rylincoln/OpenEVSE_PLUS/docs/research/v6.5.1-sourcing-research.md

# OpenEVSE PLUS v6.5.1 – station sourcing research

Scope: v6.5.1 only. That means the 2-layer EAGLE design (`OpenEVSE_PLUS_v6.5.1/`) and the 6-layer KiCad design (`OpenEVSE_PLUS_v6.5.1_6Layer/`). The KiCad schematic carries the same values as EAGLE for every part flagged below. Board BOM: `docs/research/v6.5.1-board-bom.csv`, generated from the EAGLE `.sch`. Use the BOM `value` column, not `eagle_device`.

The v6.5 drawing (`OpenEVSE_PLUS_v6.5.1/OpenEVSE_v6.5.pdf`, DWG 20250310) covers the board only. Station-level items it does not show are taken from older drawings, and each such row is tagged:
- **[v5.5]** = `OpenEVSE_PLUS_v5.5/Advanced_2024.pdf`, which the official v6.5.1 build guide links in its step 1;
- **[v5]** = `OpenEVSE_PLUS_v5/*.pdf`.

Source keys in brackets resolve in section 4. Research date: 2026-10-25.

---

## 1. Station-level parts list

### 1a. Board connectors and their mating parts

Pinouts come from the EAGLE netlist [SCH] and are cross-checked against [DWG65].

| Board ref (footprint) | Pinout (netlist) | Mating part / official SKU | Qty | Source |
|---|---|---|---|---|
| AC (JST VH, 6-pos, 3.96 mm) | 1 ACLIN, 2 ACNIN, 3 ACNIN, 4 ACRELAY (coil), 5 ACTEST2, 6 ACTEST1. All six are mains. | JST **VHR-6N** housing (VHR-6M = lance-covered variant). Contacts **SVH-21T-P1.1**, AWG 22–18; SVH-41T-P1.1 takes AWG 20–16. Board header family B6P-VH (top) / B6PS-VH (side). Official ready-made harness: contactor SKU **C240CW** ("Relay with Wiring Harness"), or a custom harness via support@openevse.com. Rating: see 2.18. | 1 housing + 6 contacts | [DWG65], [JST-VH], [ST-C240] |
| AMP_CT (Molex-style 2-pos, 2.54 mm) | 1 CT return (N$7), 2 AMP_READ. On board: R26 22 Ω burden and D11 clamp. | Official CT SKU **AMP** ships with its 2-pin connector. For a DIY lead: Molex KK 254 housing 22012027 (friction ramp) or 22013027 (with polarizing ribs), plus 2× crimp terminal 08500113 (30–22 AWG). | 1 | [ST-AMP], [MX-22012027], [MX-22013027], [MX-TERM] |
| DC_RELAY (Molex-style 3-pos, 2.54 mm) | 1 low-side drive (Q2), 2 +12 V, 3 low-side drive (Q3). Flyback diodes D5/D2 on board. | Optional; only for a 12 V DC-coil relay. Not used in the v6.5.1 Advanced kit. KK 254 housing 22012037 / 22013037 + 3× 08500113. | 0–1 | [SCH], [DWG65], [MX-22013037], [MX-2695] |
| GFCI_CT (4-pos, 2.54 mm) | 1 GND, 2 CT signal (N$20), 3 GFI_TEST_O, 4 GND. [DWG65] labels: Self Test 1/2, GFCI CT 1/2. | Official CT SKU **GFI** ships with a 4-pin connector. The board header is black in the [DWG65] photo, and no header MPN is in the BOM. Candidate DIY housing: KK 254 22012047 + 4× 08500113, if the fitted header is KK 254 (unverified). | 1 | [ST-GFI], [MX-2695] |
| FTDI (JST PH, 6-pos, 2.0 mm) | 1 GND, 2 **+12 V**, 3 +5 V, 4 RX-I, 5 TX, 6 RESET. | Housing **PHR-6** + contacts **SPH-002T-P0.5S** (AWG 30–24). Board header B6B-PH-K-S. Official cables: the Color LCD/WiFi and WiFi kits include a "custom power/communications cable", and SKU USBTTL includes a "6 pin to 6 pin (4 wires)" cable. **Conflict:** [DWG65] labels pin 2 "N/C", but the schematic puts +12 V on it, and [ADV24] shows that pin feeding the LCD's "+5v–16v DC" input. | 1 | [SCH], [DWG65], [ADV24], [JST-PH], [ST-LCD], [ST-USB] |
| I2C (JST PH, 4-pos, 2.0 mm) | 1 GND, 2 +5 V, 3 SCL, 4 SDA. | **PHR-4** + 4× SPH-002T-P0.5S. Board header B4B-PH-K-S. The official temperature sensor (MCP9808) ships with a 4-pin cable. | 1 | [SCH], [JST-PH], [ST-TEMP] |
| JP2 (Molex 1×6 friction-lock, 2.54 mm) | 1 PILOT, 2 GND, 3 PP, 4 GND, 5 PP2, 6 +5 V. Matches [DWG65]. | Optional (alternative CP/PP connection). KK 254 housing 22012067 / 22013067 + 6× 08500113. The guide does not use JP2. | 0–1 | [SCH], [DWG65], [MX-22012067], [MX-22013067] |
| PILOT (5 mm 2-pos screw terminal; BOM STOREFRONT_ID PRT-08432) | 1 PILOT (CP), 2 PP. | Takes the EV cable's 22 AWG pilot conductor with ferrule **Phoenix 3200014** (in the store ferrule kit). | 1 ferrule | [BOM], [ST-J1772], [ST-FER] |
| ISP1 (2×3 AVR-ISP) | Standard AVR ISP. | Official programmer SKU **ISP** (includes a "10 pin to 6 pin low profile cable"). | tool | [ST-ISP] |
| G1 (PE) / G2 (GND) single PTH pads; U$3 (PE) / U$9 (GND) mounting holes | The PE net includes G1, U$3, M3/M4 and the IC8 LED cathodes. The GND net includes G2 and U$9. | Earth bonding is "via ground plane metallic plate/hardware" **[v5.5]**. Neither drawing specifies a wire termination for G1/G2 (open question). | – | [SCH], [ADV24] |

### 1b. Station blocks ([DWG65], [ADV24] **[v5.5]**, [GUIDE])

| Block | Qty | Spec | Example MPN / official SKU | Source |
|---|---|---|---|---|
| Controller | 1 | OpenEVSE PLUS v6.5: "Continuous Ground Monitoring", on-board surge suppression, 10 W PSU | Store SKU PLUSv5 ($149) | [ST-CTRL] |
| Contactor (2-pole) **[v5.5]** | 1 | UL E222997; 50 A resistive / 40 A inductive; 600 VAC max; **208–240 VAC coil**, 50/60 Hz; 3"×2"×2.5". "Input and EV wires MUST be terminated with sleeve ferrules." Coil VA/current **not published**. | Packard **C240C** (SKU C240C, or C240CW with harness) | [ST-C240] |
| EV cable | 1 | J1772 Type 1, 48 A, 9 conductors (4×12 AWG, 1×10 AWG, 4×22 AWG), 300 V 105 °C, cULus, 25 ft, ferrule-terminated | Phoenix Contact **EV-T1G2C-1AC48A-25FT12ASBK11U** (SKU PHX-J1772-48A-25F). Alternative: NACS SKU NACS48A-25. | [ST-J1772], [ST-NACS] |
| GFCI CT | 1 | CCID20 (15–20 mA trip); 4-pin connector; 5-turn self-test winding (internal on current coils); nickel core; 105 °C leads; UL E235509 | Store SKU **GFI**. Drawing PN **CR8420-1K-GT7QC** (see 2.19). | [ST-GFI], [DWG65], [GUIDE] |
| Current CT | 1 | 80 A max; 2-pin connector; −40 to 105 °C; UL E235509 | Store SKU **AMP**. Drawing PN **CR8450-1K-T7QC** (see 2.19). | [ST-AMP], [DWG65] |
| LCD + WiFi **[v5.5]** | 1 | ESP32, 16 MB flash, 3.5" colour LCD, 4 RGB LEDs, I2C expansion; powered from FTDI header pin 2 (+12 V; input rated "+5v–16v DC") | OpenEVSE **Color LCD/WiFi** ($79). Alternative: WiFi kit SKU WIFI (no display). Design files: [ESP32HW]. | [ST-LCD], [ST-WIFI], [ADV24] |
| Temperature sensor **[v5.5]** | 1 | MCP9808 on 5 V I2C; 4-pin cable | Store "Temperature Sensor" ($12.99) | [ST-TEMP], [MC-9808], [ADV24] |
| LED expansion **[v5.5]** | 0–4 | 3-pixel RGB strips on the display's LED EXP header, 3-pin 9" cable | SKU RGBPIXEL3X (optional) | [ST-PIX], [ADV24] |
| Qwiic 3.3 V I2C **[v5.5]** | 0 | Header on the LCD/WiFi module (RFID/NFC etc.) | No part specified (optional) | [ADV24], [ST-LCD] |
| Enclosure + base plate | 1 | Polycarbonate 8"×5"×3", UL 746C 5VA, UL 508A Type 1/2/4/4X/12/13, UL E352997; bundle includes base plate, hardware pack and 2 small glands | SKU **P-ENC-S** (Enclosure Bundle, $69.99) | [ST-ENC] |
| Cable glands / strain relief | 2 | UL E51579; nylon 6/6; TPE seal; cable OD 0.450–0.709"; one for input (left), one for EV cable (right) | SKU **CGSMALL** (Heyco Series 35 datasheet linked by the store) | [ST-GLAND], [HEYCO], [GUIDE] |
| Input cable or hardwire | 1 | 105 °C, ferrule-terminated. 48 A continuous on NEMA 14-60, 40 A on 14-50, 24 A on 14-30; blunt option for hardwire. Kit rated 208–264 VAC, circuits ≤60 A, 50 A max continuous output. | SKU **14XX** | [ST-IN], [ST-KIT] |
| Ferrules | 1 kit | 5× 6 AWG power, 5× twin 12 AWG power, 2× 10 AWG ground, 2× pilot | Phoenix **3200140**, **3201000**, **3200108**, **3200014** (store "Wire Ferrule Kit"; the store text shows the Digi-Key numbers 349917/349965/349914/349905) | [ST-FER] |
| Ground bar **[v5.5]** | 1 | Terminates input and EV-cable grounds; mounted to the plate with 1 washer + one 1/4" self-threading screw | MPN not published (open question) | [ADV24], [GUIDE] |
| Controller standoffs + screws | 4 + 8 | 4.5 mm hex × 10 mm standoffs. 4× M2.5×6 into the plate (blue Loctite) and 4× M2.5×6 for the controller. | Enclosure hardware pack | [GUIDE], [ST-ENC] |
| Contactor screws | 4 | 1/4" self-threading | Hardware pack | [GUIDE] |
| Plate screws | 6 | Coarse-thread 6 mm | Hardware pack | [GUIDE] |
| Lid screws | 6 | 6-32 × 1-1/4" | Hardware pack | [GUIDE] |
| Wire management | – | Zip ties near the CTs; route LV wires low and HV wires high | No part | [GUIDE] |
| Holster | 0–1 | UV-treated polycarbonate J1772 holster/cord wrap | SKU JHOLSTER | [ST-HOL] |
| Button **[v5]** | 0–1 | Button header on the LCD (v5 drawings); the RGB LCD v3 has a "3 pin header for button". Not shown on v6.5 or [ADV24]. | No MPN published | [STD5], [ST-RGB] |
| Cable lock **[v5]** | 0 | Only for socketed (IEC) stations: "Requires external 12V Supply and motor driver such as Polulu 1451". Not applicable to a tethered J1772 cable. | Pololu 1451 (per drawing) | [STD3P] |
| Programming / serial | tool | ISP programmer (firmware). USB-TTL "Serial is not supported for firmware upload". | SKUs ISP, USBTTL | [ST-ISP], [ST-USB] |

---

## 2. Datasheet checks

Verdicts: confirmed / refuted / unclear. "Calc" marks arithmetic of mine that uses the cited figures.

| # | Claim checked | Verdict | Exact figure(s) | Source |
|---|---|---|---|---|
| 2.1 | LMV358 (IC1 value) can run on ±12 V | **Refuted** | Abs max supply (V+ − V−) **5.5 V**; recommended 2.7–5.5 V. ±12 V = 24 V. LMV358A abs max 6 V. The part fitted as IC1 cannot be an LMV358; both the EAGLE and KiCad schematics list "LMV358". | [TI-LMV358], [TI-LMV358A], [BOM], [KSCH] |
| 2.2 | LM358 as open-loop pilot comparator (+IN 0/5 V PWM, −IN 2.5 V, OUT→820 Ω→CP) | **Refuted** for the J1772 edge requirement. Supply and input range are OK. | **Supply:** abs max ±16 V / 32 V (LM358B ±20 V / 40 V); recommended 3–30 V. **Input:** VCM V− to V+ − 2 V, so the 0–5 V inputs are within range. **Slew:** 0.3 V/µs (LM358B 0.5 V/µs). Calc: a 10–90 % swing of 24 V is 19.2 V, which takes 64 µs (LM358B 38 µs) against a < 2 µs requirement (2.5). **Positive swing:** 2 V typ / 3 V max below V+ (VS 30 V, RL ≥ 10 kΩ); 4 V max at RL 2 kΩ. **Output current:** source 20 mA min / 30 mA typ; sink 10 mA min / 20 mA typ. | [TI-LM358], [TI-FE6] |
| 2.3 | LF353 as the pilot driver | **Unclear** (edges pass at typical slew, fail at minimum; swing short of ±12 V) | **Supply:** ±18 V max. **Swing:** VOM ±12 V min / ±13.5 V typ at ±15 V supply, RL 10 kΩ, i.e. 1.5–3 V headroom. Calc: about ±9 to ±10.5 V at ±12 V rails. **Slew:** 8 min / 13 typ V/µs. Calc: 19.2 V takes 1.5 µs typ, 2.4 µs at minimum. **Input:** VCM from V− + 4 V to V+ − 4 V (±8 V at ±12 V rails), so the 0–5 V inputs are in range. | [TI-LF353], [TI-FE6] |
| 2.4 | TL082 as the pilot driver | **Unclear** (same pattern as LF353) | **Supply:** VS max 36 V (TL08xM, NS/PS packages) or 42 V (others); recommended 4.5–40 V. **Swing:** VOM ±13.5 typ / ±12 min (RL 10 kΩ), ±10 min (RL ≥ 2 kΩ), at ±15 V. **Slew:** 8 min / 20 typ V/µs (TL08xC/I). Calc: 1.0 µs typ, 2.4 µs at minimum. **Input:** range starts at V− + 4 V. | [TI-TL082] |
| 2.5 | J1772 / IEC 61851-1 pilot generator requirements (for SPICE) | **Confirmed** from a first-party summary. **Unclear:** tolerances. | **Signal:** ±12 V, 1 kHz, 1 kΩ source. Driver needs "a minimum of ±12mA sinking and sourcing current with a rise time and fall time < 2μs, per SAE J1772", measured 10–90 % at the generator before the 1 kΩ resistor. **States:** A 12 V DC (open); B1 9 V DC (EV load 2.74 kΩ); B2 9 V / −12 V at 1 kHz; C 6 V (2.74 kΩ ∥ 1.3 kΩ = 882 Ω, through the EV diode); D 3 V (246 Ω); E 0 V; F −12 V. **Boundary bands:** B 8/9/10 V, C 5/6/7 V, D 2/3/4 V. **Duty:** 5 % = digital communication. **Not found in any free first-party document:** the ±12 V amplitude tolerance (±0.6 V?) and the 1 kΩ ±3 % source tolerance. SAE J1772 and IEC 61851-1 are paywalled. Board fact: R1 = **820 Ω**, not 1 kΩ, so 180 Ω would have to come from the driver output impedance; whether that is intentional is unverified. | [TI-FE6], [TI-BV2], [SAE-J1772], [IEC-61851], [SCH] |
| 2.6 | TC1044S on the +12 V rail; output resistance | **Unclear / marginal** | **Abs max supply:** +13 V. **Operating range** VH2 (LV open): 3–12 V over temperature. IRM-10-12 can sit at 12.3 V (12 V ±2.5 %), which exceeds the 12 V operating max but stays below the 13 V abs max. The IRM's OVP (13.8–16.2 V) trips above the TC1044S abs max. **ROUT:** 60 typ / 100 max Ω at V+ = 5 V, IOUT 20 mA; 70/120 Ω at −40…85 °C; not specified at 12 V. **FOSC:** 10 kHz, 45 kHz with BOOST = V+ (as wired). **Supply current with boost:** ≤350 µA (−40…85 °C). | [MC-TC1044], [MW], [SCH] |
| 2.7 | AP63203 vs AP63205; effect of FB tied to the output | **AP63203 refuted** for this net | AP63203 is a fixed 3.3 V part (VFB 3.27/3.30/3.33 V). AP63205 is a fixed 5 V part (4.95/5.00/5.05 V). The datasheet's typical circuit ties FB of the AP63205 directly to VOUT. On the board FB sits on the output net "+5V" (after L2) with no divider, so an **AP63203 regulates "+5V" to 3.3 V**. **Consequences:** the ATmega328P at 16 MHz needs 4.5–5.5 V ("0–20 MHz @ 4.5–5.5 V"); the AQH2223 LED current falls to about (3.3 − 1.18)/330 ≈ 6.4 mA (calc), below IFT max 10 mA (2.13). **Recommended parts:** AP63205: L 4.7 µH, C1 10 µF, C2 2×22 µF, C3 (BST) 100 nF. AP63203: L 3.9 µH. The general range is 2.2–10 µH, so the fitted 3.3 µH is inside it. **Marking:** AP63203WU-7 = T4, AP63205WU-7 = T5, which lets you check a populated board. | [DI-AP], [MC-328], [SCH] |
| 2.8 | Mean Well IRM-10 variant, temperature range, input vs 277 VAC | **Confirmed**, with derating caveats. **BOM value refuted.** | **Models:** -3.3/-5/-12/-15/-24; IRM-10-12 = 12 V, 0.85 A. **Input:** 85–305 VAC / 120–430 VDC, 0.125 A typ at 277 VAC; leakage < 0.25 mA at 277 VAC. **Working temperature:** −30 to +85 °C "(Refer to Derating Curve)"; the curve reads 100 % load to 50 °C, 50 % at 70 °C, ~10 % at 85 °C. **Ratings:** OVC III per IEC 61558-1/-2-16, OVC II per IEC/UL 62368-1; I/P–O/P 4.2 kVAC; Class II. **BOM vs board:** the BOM says "IRM-10-5", but PS1 V+ is on the +12V net and the [DWG65] photo shows an IRM-10-12 labelled "277VAC for North America only". | [MW], [DWG65], [SCH] |
| 2.9 | 1210 thick-film resistors (R32–R39, 2×180 kΩ per branch) at 277 VAC | **Confirmed** on rms voltage and power. Per-resistor peak is close to 200 V. | **Yageo RC1210:** 1/2 W at 70 °C; max working 200 V (DC or AC rms, or √(P·R) if lower; √(0.5×180k) = 300 V, so 200 V governs); max overload 500 V; dielectric withstand 500 V. **Calc** (diode blocks the reverse half-cycle): at 277 VAC (391.7 Vpk), Ipk ≈ 1.08 mA, 195 Vpk / 97 Vrms per resistor, P ≈ 53 mW. At 305 VAC (+10 %): 1.19 mA, 215 Vpk / 107 Vrms, 64 mW (about 13 % of rating). | [YAG-RC], [SCH] |
| 2.10 | HCPL-2731: LED current, CTR, CTR ageing | **Confirmed** at 230/277 V L–PE. **Unclear** at 120 V L–PE. | **CTR:** 400 % min / 1800 typ / 5000 max at IF 0.5 mA, VCC 4.5 V. **Recommended IF(ON):** 0.5–12 mA. **LED limits:** IF(avg) 20 mA; VR 5 V; VF 1.4 typ / 1.7 max V at 1.6 mA. Guaranteed 0–70 °C; operating −40 to 85 °C. **Ageing:** "high CTR reduce the magnitude and effects of CTR degradation"; Broadcom's lifetime paper says "CTR < 10% loss after 30 field years of typical operations". **Calc peak IF:** 1.08 mA at 277 V; **0.465 mA at 120 V L–PE** (240 V split-phase or 208 V wye), which is below the 0.5 mA guaranteed-CTR point. **Board facts:** outputs have no external pull-ups (they rely on the MCU); onsemi HCPL2731S is obsolete/NRND. | [BRCM-2731], [BRCM-LED], [ON-2731], [SCH] |
| 2.11 | Tantalum derating: C17 10 µF 6.3 V on VCC (≈5 V) | **Refuted** (if MnO2) | KEMET T491 (MnO2): recommended max application voltage **50 % of VR** at −55 to 85 °C, 33 % at 85–125 °C. Calc: 5 V / 6.3 V = 79 % of VR, against a 3.15 V allowance; a 10 V part at 5 V = 50 %. The fitted part's chemistry and MPN are unknown (BOM gives only SparkFun PROD_ID CAP-13210). C14/C22 (10 µF EIA3216, polarized) have no voltage rating in the BOM. C22 sits on +12 V: calc 12.3 V / 25 V = 49 %. | [KEM-T491], [BOM], [SCH] |
| 2.12 | MLCC DC-bias loss, 10 µF 0805 at 12 V | **Confirmed**: large loss | TDK C2012X5R1E106K125AB (10 µF 25 V X5R 0805), 25 °C reference curve: 4.80 µF at 5 V, 2.19 µF at 10 V, **1.67 µF at 12.5 V (−83 %)**, 0.74 µF at 25 V. Affected 10 µF 0805 parts: C6, C28 (+12 V), C5 (−12 V), C13 (charge-pump flying cap). The BOM gives no voltage rating for them. For comparison, 22 µF 16 V 0805 (C2012X5R1C226K125AC) gives 6.97 µF at 5 V (−68 %). This matters for C29/C33. | [TDK-106], [TDK-226], [BOM], [SCH] |
| 2.13 | AQH2223 driving the contactor coil | **Unclear** | **Ratings:** non-zero-cross; VDRM 600 V; IT(rms) 0.9 A (graph: flat to ~40 °C, ~0.3 A at 85 °C); ITSM 9 A (60 Hz, 1 cycle); IH max 25 mA; IFT max 10 mA (recommended IF 20 mA); VF 1.18 typ V; IDRM 100 µA; dv/dt 200 V/µs min; Viso 5000 VAC; Topr −30 to +85 °C. **Loads:** "handles both 100 and 200 V AC loads"; recommends a snubber or varistor on the load side (M1 sits across the coil, ACNIN–ACRELAY). **Calc LED current:** ≤ (5.0 − 1.18)/330 = 11.6 mA (less MCU pin drop), which is above IFT max but below the recommended 20 mA. **Open:** the C240C coil current is unpublished, so IT and IH margins cannot be checked. Manufacturer URL not found; a mirror of Panasonic document ASCT1B272E was used. | [PAN-AQH], [SCH], [ST-C240] |
| 2.14 | P6SMB16CA standoff vs ±12 V pilot | **Confirmed** | VWM 13.6 V; VBR 15.2–16.8 V at 1 mA; IR ≤ 1 µA at VWM; VC 22.5 V at IPPM 26.7 A; bidirectional (CA). Calc: ±12.3 V worst case < 13.6 V. | [VIS-P6] |
| 2.15 | MOVs line-to-PE (M3 L–PE, M4 N–PE; M2 L–N, M1 across coil): leakage, ground-fault interaction, thermal protection | **Unclear** (BOM gives no rating; standards paywalled) | **BOM:** value "MOV", no voltage. Footprint pad offset Δx 9.89 mm / Δy 2.54 mm. **UltraMOV V20E320P:** MCOV 320 VAC / 420 VDC, 273 J, 10 kA, VN 459–561 V, VC 840 V at 100 A; 20 mm lead spacing 9–11 mm fits the footprint. V20E300P (300 VAC) is below 305 V (277 + 10 %). **TMOV20RP320E (thermally protected):** same electrical class; its "thermally activated element designed to open" under UL 1449 abnormal-overvoltage limited-current conditions; UL1449 E320116; GFCI listed as an application. Its 7.5 mm lead spacing does not fit. **Leakage:** neither datasheet tabulates standby current at MCOV (UltraMOV: "characterized for maximum standby current"). **Ground-fault interaction:** the CCID CT encloses the EV-cable conductors (guide step 5), so the board's L/N–PE currents are not seen by the station's own CCID; an upstream RCD/GFCI breaker does see them. Continuous L–PE contributors: IRM-10 < 0.25 mA at 277 V (output bonded to PE); HCPL ground-monitor branch ≈ 0.54 mA rms per energised channel at 277 V (calc, 2.9). MOV leakage is not quantified. UL 2231 / UL 2594 / IEC 61851-1 requirements are not consulted (paywalled). | [SCH], [LF-UMOV], [LF-UMOVP], [LF-TMOV], [GUIDE], [MW], [UL-2594], [IEC-61851] |
| 2.16 | 1N4004 vs an SMA equivalent (D7–D10) | **Refuted** as listed | **1N4004:** DO-41 only, "NOT RECOMMENDED FOR NEW DESIGNS"; 400 V; doesn't fit the SMA pads. The footprint's library device is **MBRA340T3** (a 40 V Schottky), so ordering by device name is dangerous. **Diodes S1x SMA:** VRRM 400 V (S1G) / 600 V (S1J) / 1000 V (S1M); 1 A; IR 5 µA; suggested pad spacing C = 4.00 mm, matching the 4.0 mm pad centres. **Calc reverse voltage** on D7/D9 with 277 V L–N (N≈PE): ≈392 Vpk, **431 V at +10 %**, so S1G/1N4004 (400 V) is insufficient. At 240 V split-phase the reverse voltage is ≈171 Vpk (D8 clamps the shared node). | [DI-1N], [DI-S1], [SCH], [BOM] |
| 2.17 | Reinforced/basic creepage and clearance, mains (≤277 VAC) to SELV; verdict on the 4.3–4.7 mm gap ACLIN (IC7 pin 8) ↔ +5V (IC8 pin 8), top layer, no slot, default net class | **Basic at PD2: adequate. Reinforced at OVC III: not adequate. PD3: unclear.** | **Status of the standards:** IEC 60664-1 is paywalled; the VDE preview of ed. 3.1 (2025) shows only the ToC. Figures below are TI's reproduced subsets. **Impulse (Table F.1, ≤300 V L–N):** OVC II 2.5 kV, OVC III 4.0 kV; reinforced = one step higher (4.0 / 6.0 kV). **Clearance (Table F.2, PD2):** 2.5 kV → 1.5 mm, 4.0 kV → 3.0 mm, 6.0 kV → 5.5 mm. IEC 62368-1 Table 10: 1.8 / 3.8 / 7.9 mm. PD3: 0.8 mm floor; higher PD3 values not in the free excerpt. **Creepage (Table F.4, 400 V row, a bound above 300/320 V):** PD1 1.0 mm; PD2 MG I 2.0, MG II 2.8, **MG III 4.0 mm**; reinforced doubles this (MG III 8.0 mm). The printed-wiring PD2 column at 400 V gives 2.0 mm basic / 4.0 mm reinforced. FR4 is typically MG IIIa. The 320 V row and PD3 creepage are not freely available. **Basic vs reinforced:** TI's table lists primary ↔ *earthed* SELV as basic and primary ↔ *unearthed* SELV as reinforced. Board GND is bonded to PE (U$9/G2 + metal plate, [ADV24]). The end-product standard (IEC 61851-1 / UL 2231 / UL 2594) decides and was not consulted. **Verdict for 4.3–4.7 mm:** basic passes clearance up to OVC III (3.0 mm; 3.8 mm under 62368-1) and creepage (≤ 4.0 mm). Reinforced fails OVC III clearance (5.5 mm) and MG III creepage (8.0 mm); it passes only with OVC II and the printed-wiring column (4.0 mm, marginal). The gap was measured on the EAGLE 2-layer board; the 6-layer layout was not measured. **Components:** HCPL-2731 DIP-8 external clearance 7.1 mm / creepage 7.4 mm (SO-8 4.9 / 4.8 mm); CTI 200, material group IIIa; VISO 3750 Vrms; VIORM 630 Vpk and installation class I–IV at ≤300 Vrms (IEC 60747-5-5, **option 060 only**). AQH2223: Viso 5000 VAC, Riso ≥ 50 GΩ; **no creepage/clearance figure published**. | [TI-419], [TI-AR5], [VDE-60664], [IEC-60664], [BRCM-2731], [PAN-AQH], [SCH], [ADV24] |
| 2.18 | JST VH carries 277 VAC (mains, coil and AC-test all on one VH 6-pin) | **Refuted** | **JST VH:** voltage rating **250 V AC/DC**; 10 A (AWG 16, standard header) / 7 A (AWG 18, shrouded header); −40 to +105 °C. JST lists UL E60389 / CSA LR20812 / TÜV R75122 registrations with no voltage, and notes "specifications registered to overseas standards may differ". 277 VAC exceeds 250 V. **Official ranges:** the kit range of 208–264 VAC also tops 250 V. The guide says "100 to 250v". The C240C coil is 208–240 VAC. **No VH variant ≥300 V found.** **Same-pitch ≥300 V family (not intermateable with VH):** Molex KK 396: header 26604060 (3.96 mm, **600 V AC (RMS)/DC**, 7.0 A); housing 09503061 (6-ckt); terminal 08500106 (18–24 AWG). Footprint/hole compatibility with the JST-VH-6 pads is unverified. | [JST-VH], [JST-REG], [ST-KIT], [GUIDE], [ST-C240], [MX-26604060], [MX-09503061], [MX-08500106] |
| 2.19 | CT part numbers CR8420-1K-GT7QC (GFCI), CR8450-1K-T7QC (current) | **Unclear** | **Not on CR Magnetics' public CR8400 page.** Closest catalogue parts: **CR8420-1000-G** (ground fault, nickel): Ir 20 A, Vmax 1.4 V, Te 1011, DCR 44 Ω. **CR8450-1000:** Ir 100 A, Vmax 16.5 V, Te 1021, DCR 21 Ω, "Custom Lead Lengths Available". Series-wide: insulation 3500 VAC / 1 min; −40 to +85 °C (general purpose and nickel). The "-1K-…T7QC" suffixes look like custom variants; confirm with CR Magnetics or OpenEVSE. OpenEVSE's store lists UL E235509, 105 °C leads and −40…105 °C for both CTs, which differs from the catalogue's 85 °C. | [CRM], [DWG65], [ST-GFI], [ST-AMP] |
| 2.20 | Manufacturer SPICE models (TI) | **Confirmed** (zips download) | **LF353:** SLOJ039 (LF353.301, 1989 Boyle-type macromodel). **TL072:** SLOJ067. **TL082:** SLOJ070. **LM358 / LMx58-LM2904:** PSpice Rev C, SNOM268 (lmx58_lm2904.lib). **LM358B:** PSpice SLOM472; TINA-TI SLOM473. | [TI-SPICE] |
| 2.21 | ATmega328P supply for 16 MHz (relevant to 2.7) | **Confirmed** | Speed grades: 0–4 MHz @ 1.8–5.5 V, 0–10 MHz @ 2.7–5.5 V, 0–20 MHz @ 4.5–5.5 V. Q1 = 16 MHz. | [MC-328], [BOM] |

Plain statements where primary sources contradict the brief or the design files:
- **IC1 "LMV358" cannot run on ±12 V** (2.1).
- **U1 "AP63203" would make the "+5V" rail 3.3 V** (2.7).
- **"IRM-10-5" is a BOM error;** the board uses IRM-10-12 (2.8).
- **277 VAC exceeds the JST VH rating** (250 V), and also exceeds the C240C coil rating and the official kit range (2.18).
- **FTDI pin 2:** [DWG65] says N/C, while the schematic says +12 V.
- **±0.6 V / 1 kΩ ±3 % pilot tolerances:** not confirmed by any free first-party source (2.5).
- **Official v6.5.1 build guide:** it links the v5.5 drawings in step 1 and refers to the "v5 Diagram" in step 9.

---

## 3. Corrected sourcing lines

| BOM line (value / device) | Problem | Orderable MPN or open question | Source |
|---|---|---|---|
| **C29, C33** "22" on 1.0UF-0805-25V (PROD_ID CAP-11625 = 1.0 µF) | The value field reads 22, but the device and PROD_ID say 1.0 µF. The netlist puts them on +5V/GND as U1 output caps. | **22 µF**, per the AP6320x tables (C2 = 2×22 µF). Example: TDK **C2012X5R1C226K125AC** (22 µF ±10 %, 16 V, X5R, 0805). Note it is ≈7.0 µF each at 5 V. **Open:** whether 0805 is intended. | [DI-AP], [TDK-226], [SCH] |
| **C32** "100nf" on the same 1.0 µF device | The netlist places it BST–SW, i.e. the bootstrap cap. | **100 nF**, per the datasheet C3. Example: TDK **C2012X7R1H104K085AA** (0.1 µF, 50 V, X7R, 0805). | [DI-AP], [TDK-104], [SCH] |
| **IC2** ATMEGA328P-AU, attribute MPN=ATMEGA8-16AU (and Farnell/Newark codes) | The MPN attribute is left over from the atmel/MEGA8-AI library device. | Microchip **ATmega328P-AU** (tray) / **ATmega328P-AUR** (T&R), 32A TQFP. Firmware target m328p. | [MC-328], [FW], [BOM] |
| **R32–R39** "180k" on 0.1OHM-1/2W-1%(1210), PROD_ID RES-12374 | The device name and PROD_ID describe a 0.1 Ω part. | Yageo **RC1210FR-07180KL** (180 kΩ, 1 %, 1/2 W, 200 V). The MPN is built from the RC_L ordering-code scheme; availability was not checked. | [YAG-RC], [BOM] |
| **Q2, Q3** "2222A" on BCX70* SMD (SOT-23) | Generic value. | Diodes **MMBT2222A-7-F** (SOT-23, marking K1P; VCEO 40 V, VCBO 75 V, IC 600 mA). The library maps B=1, E=2, C=3; check against the datasheet's pinout drawing. | [DI-2222], [SCH] |
| **U1** AP63203 (SparkFun VREG-15244) | Gives 3.3 V on "+5V" (2.7). | **AP63205WU-7** (marking T5). **Open:** confirm the fitted part from a board's marking (T4 = AP63203). | [DI-AP] |
| **L2** 3.3 µH (NR5040 footprint) | Inside the datasheet range of 2.2–10 µH; Table 3 recommends 4.7 µH for AP63205. | Optional 4.7 µH: Taiyo Yuden **LCXND5050YAL4R7NMG** (successor to NRS5040T4R7NMGKV; 4.7 µH ±30 %, 3.1 A, 4.9×4.9×4.1 mm). Footprint fit not checked. | [DI-AP], [TY-L] |
| **PS1** IRM-10-5 | Contradicted by the +12V net and the board photo. | Mean Well **IRM-10-12**. | [MW], [DWG65] |
| **IC1** LMV358 | Cannot run on ±12 V. | **Open:** identify the fitted IC1. Checked candidates: LM358 is too slow; LF353/TL082 are borderline (2.2–2.4). | [TI-LMV358] |
| **IC8** HCPL-2731S (onsemi naming) | onsemi HCPL2731S is obsolete/NRND. | Broadcom **HCPL-2731-500E** (gull-wing, T&R) or **-300E** (gull-wing, tube); **-560E / -360E** add IEC 60747-5-5. Check the gull-wing lead span against the 10.16 mm pad rows. onsemi's replacement is HCPL273xM. | [BRCM-2731], [ON-2731] |
| **IC7** AQH2223 (SIL8 SMD footprint) | The base part number is the DIP version. | Panasonic **AQH2223A** (SMD terminal, tube) / **AQH2223AX** or **AQH2223AZ** (tape & reel, by pin orientation). **Open:** current Panasonic production status (manufacturer page not found). | [PAN-AQH] |
| **IC4** TC1044S | No temperature grade given. | Microchip **TC1044SEOA** (SOIC-8, −40 to +85 °C) or TC1044SCOA (0–70 °C). | [MC-TC1044] |
| **D7–D10** "1N4004" on MBRA340T3 (SMA) | DO-41 part on an SMA footprint whose device is a 40 V Schottky; 400 V is too low for 277 V (2.16). | Diodes **S1M-13-F** (1000 V) or **S1J-13-F** (600 V). | [DI-S1], [DI-1N] |
| **M1–M4** "MOV" | No voltage or energy rating. | **Open.** Footprint-compatible candidate: Littelfuse **V20E320P** (320 VAC). Thermally protected alternative **TMOV20RP320E** needs 7.5 mm lead spacing (footprint change). | [LF-UMOV], [LF-TMOV] |
| **C17** 10 µF 6.3 V 0603 tantalum on VCC | 79 % of VR (2.11). | **Open:** fitted chemistry. A 10 V option in the same 0603 (M) case: KYOCERA AVX **F981A106MMA** (F98 is "Not recommended for new designs"). | [AVX-F98], [KEM-T491] |
| **C5, C6, C13, C28** "10uf" 0805 | No voltage rating; sit at ±12 V. | ≥25 V, e.g. TDK **C2012X5R1E106K125AB**. Only about 1.7 µF remains at 12 V (2.12). | [TDK-106] |
| **C14, C22** "10uf" EIA3216 polarized | No voltage rating; C22 sits on +12 V. | **Open:** dielectric/chemistry. If MnO2 tantalum, C22 needs ≥25 V for the 50 % rule. | [KEM-T491] |
| **F1** BEL1.6AFUSE (BELFUSE1A footprint) | Series and voltage rating not given. | **Open:** Bel Fuse series and a voltage rating ≥ the input voltage. Not researched further. | [BOM] |

---

## 4. Sources

### Repository files
| Key | Path |
|---|---|
| [BOM] | `docs/research/v6.5.1-board-bom.csv` |
| [SCH] | `OpenEVSE_PLUS_v6.5.1/OpenEVSE_PLUS_v6.5.1.sch` (netlist, library pads, design rules) |
| [KSCH] | `OpenEVSE_PLUS_v6.5.1_6Layer/v6_6layer.kicad_sch` |
| [DWG65] | `OpenEVSE_PLUS_v6.5.1/OpenEVSE_v6.5.pdf` (= `OpenEVSE_PLUS_V6.5.1.png`), DWG 20250310 |
| [ADV24] | `OpenEVSE_PLUS_v5.5/Advanced_2024.pdf`, DWG 202406913 |
| [STD5] | `OpenEVSE_PLUS_v5/Standard_v5.pdf` |
| [STD3P] | `OpenEVSE_PLUS_v5/Standard_3Phase.pdf` |

### OpenEVSE (official)
| Key | URL |
|---|---|
| [GUIDE] | https://github.com/OpenEVSE/Guides/blob/main/v6.5.1-openevse-advanced/README.md |
| [FW] | https://github.com/OpenEVSE/open_evse (firmware/targets/m328p) |
| [ESP32HW] | https://github.com/OpenEVSE/ESP32_hardware |
| [ST-CTRL] | https://store.openevse.com/products/openevse-v6-5-universal-evse-controller |
| [ST-KIT] | https://store.openevse.com/products/advanced-kit |
| [ST-C240] | https://store.openevse.com/products/packard-c240c-40a-contactor-208-240vac-coil-50-60hz |
| [ST-J1772] | https://store.openevse.com/products/j1772-cable-48a-ultra-flexible |
| [ST-NACS] | https://store.openevse.com/products/nacs-tesla-ev-cable-25 |
| [ST-AMP] | https://store.openevse.com/products/current-measurement-transformer-kit |
| [ST-GFI] | https://store.openevse.com/products/gfci-current-transformer |
| [ST-LCD] | https://store.openevse.com/products/openevse-color-lcd-wifi |
| [ST-WIFI] | https://store.openevse.com/products/openevse-wifi-kit |
| [ST-RGB] | https://store.openevse.com/products/openevse-rgb-lcd |
| [ST-PIX] | https://store.openevse.com/products/display-expansion-color-led-3-add-on-pixels |
| [ST-TEMP] | https://store.openevse.com/products/temperature-sensor |
| [ST-ENC] | https://store.openevse.com/products/custom-enclosure-poly-carbonate-standard |
| [ST-GLAND] | https://store.openevse.com/products/cable-gland-cg-16 |
| [ST-IN] | https://store.openevse.com/products/ac-cable-nema-14-50p-50a |
| [ST-FER] | https://store.openevse.com/products/wire-ferrule-kit (links Digi-Key pages for Phoenix 3200140, 3201000, 3200108, 3200014) |
| [ST-USB] | https://store.openevse.com/products/usb-to-serial-comm |
| [ST-ISP] | https://store.openevse.com/products/openevse-programmer |
| [ST-HOL] | https://store.openevse.com/products/j1772-holster-and-cord-hanger |
| [HEYCO] | https://www.heyco.com/Liquid_Tight_Cordgrips/pdf/Series-35-PG.pdf (linked from [ST-GLAND]) |

### Manufacturer documents
| Key | URL |
|---|---|
| [TI-LMV358] | https://www.ti.com/lit/ds/symlink/lmv358.pdf (SLOS263Y) |
| [TI-LMV358A] | https://www.ti.com/lit/ds/symlink/lmv358a.pdf |
| [TI-LM358] | https://www.ti.com/lit/ds/symlink/lm358.pdf (SLOS068AB) |
| [TI-LF353] | https://www.ti.com/lit/ds/symlink/lf353.pdf |
| [TI-TL082] | https://www.ti.com/lit/ds/symlink/tl082.pdf |
| [TI-SPICE] | https://www.ti.com/lit/zip/SLOJ039 · https://www.ti.com/lit/zip/SLOJ067 · https://www.ti.com/lit/zip/SLOJ070 · https://www.ti.com/lit/zip/SNOM268 · https://www.ti.com/lit/zip/SLOM472 · https://www.ti.com/lit/zip/SLOM473 (product pages: https://www.ti.com/product/LF353, /TL072, /TL082, /LM358, /LM358B) |
| [TI-FE6] | https://www.ti.com/lit/pdf/tidufe6 (TIDUFE6A, TIDA-010939, Sept 2025 rev. Dec 2025) |
| [TI-BV2] | https://www.ti.com/lit/pdf/tidubv2 |
| [TI-419] | https://www.ti.com/lit/pdf/slup419 (Demystifying Clearance and Creepage, 2024) |
| [TI-AR5] | https://www.ti.com/lit/pdf/sluaar5 |
| [DI-AP] | https://www.diodes.com/assets/Datasheets/AP63200-AP63201-AP63203-AP63205.pdf (DS41326 Rev 3-2) |
| [DI-S1] | https://www.diodes.com/assets/Datasheets/ds16003.pdf |
| [DI-1N] | https://www.diodes.com/assets/Datasheets/ds28002.pdf |
| [DI-2222] | https://www.diodes.com/assets/Datasheets/MMBT2222A.pdf |
| [MW] | https://www.meanwell.com/Upload/PDF/IRM-10/IRM-10-SPEC.PDF |
| [JST-VH] | https://www.jst-mfg.com/product/pdf/eng/eVH.pdf |
| [JST-PH] | https://www.jst-mfg.com/product/pdf/eng/ePH.pdf |
| [JST-REG] | https://www.jst-mfg.com/product/pdf/list_of_registered_overseas_standards.pdf |
| [MX-22013037] | https://www.molex.com/en-us/products/part-detail/22013037 |
| [MX-22012027] | https://www.molex.com/en-us/products/part-detail/22012027 |
| [MX-22013027] | https://www.molex.com/en-us/products/part-detail/22013027 |
| [MX-22012067] | https://www.molex.com/en-us/products/part-detail/22012067 |
| [MX-22013067] | https://www.molex.com/en-us/products/part-detail/22013067 |
| [MX-2695] | https://www.molex.com/en-us/products/series-chart/2695 (KK 254 housings incl. 22012037/22012047) |
| [MX-TERM] | https://www.molex.com/en-us/products/series-chart/2759 (terminal 08500113) |
| [MX-26604060] | https://www.molex.com/en-us/products/part-detail/26604060 |
| [MX-09503061] | https://www.molex.com/en-us/products/part-detail/09503061 |
| [MX-08500106] | https://www.molex.com/en-us/products/part-detail/08500106 |
| [BRCM-2731] | https://docs.broadcom.com/doc/AV01-0546EN (doc AV02-0546EN) |
| [BRCM-LED] | https://docs.broadcom.com/doc/AV02-3401EN |
| [ON-2731] | https://www.onsemi.com/products/standard-products/optocouplers/phototransistors/hcpl2731 |
| [PAN-AQH] | Panasonic AQ-H datasheet ASCT1B272E; copy at https://sigma.octopart.com/46752/datasheet/Panasonic-AQH2223.pdf (no Panasonic-hosted URL found) |
| [VIS-P6] | https://www.vishay.com/docs/88370/p6smb.pdf |
| [LF-TMOV] | https://www.littelfuse.com/assetdocs/varistors-tmov-datasheet?assetguid=bd475732-1071-4352-b8aa-f78b0007eb05 |
| [LF-UMOV] | https://www.littelfuse.com/assetdocs/varistors-ultramov-datasheet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 |
| [LF-UMOVP] | https://www.littelfuse.com/products/overvoltage-protection/varistors/radial-leaded-varistors/ultramov/v20e320pl1a7 |
| [CRM] | https://www.crmagnetics.com/Assets/ProductPDFs/CR8400%20Series%20Specification%20Page.pdf |
| [MC-TC1044] | https://ww1.microchip.com/downloads/en/DeviceDoc/21348a.pdf (DS21348A) |
| [MC-328] | https://ww1.microchip.com/downloads/en/DeviceDoc/ATmega48A-PA-88A-PA-168A-PA-328-P-DS-DS40002061B.pdf |
| [MC-9808] | http://ww1.microchip.com/downloads/en/DeviceDoc/25095A.pdf |
| [YAG-RC] | Yageo RC_L datasheet, "Product specification – August 02, 2022 V.12"; copy at https://cdn.sparkfun.com/assets/f/9/4/2/a/25168-resistor.pdf (yageo.com/yageogroup.com links returned 404) |
| [KEM-T491] | https://content.kemet.com/datasheets/KEM_T2005_T491.pdf (T2005_T491, 2026-07-08) |
| [AVX-F98] | https://datasheets.kyocera-avx.com/F98.pdf |
| [TDK-106] | https://product.tdk.com/en/search/capacitor/ceramic/mlcc/info?part_no=C2012X5R1E106K125AB ("Characteristic Graph", capacitance vs DC bias) |
| [TDK-226] | https://product.tdk.com/en/search/capacitor/ceramic/mlcc/info?part_no=C2012X5R1C226K125AC |
| [TDK-104] | https://product.tdk.com/en/search/capacitor/ceramic/mlcc/info?part_no=C2012X7R1H104K085AA |
| [TY-L] | https://ds.yuden.co.jp/TYCOMPAS/ap/detail?pn=LCXND5050YAL4R7NMG&u=I |

### Standards (catalogue pages; contents paywalled)
| Key | URL |
|---|---|
| [IEC-60664] | https://webstore.iec.ch/en/publication/59671 (IEC 60664-1:2020) |
| [VDE-60664] | https://www.vde-verlag.de/iec-normen/preview-pdf/info_iec60664-1%7Bed3.1%7Den.pdf (ed. 3.1 preview, ToC only) |
| [IEC-61851] | https://webstore.iec.ch/en/publication/33644 (IEC 61851-1:2017) |
| [SAE-J1772] | https://www.sae.org/standards/content/j1772_202401/ |
| [UL-2594] | https://webstore.ansi.org/standards/ul/ul2594ed2022 |
