rylincoln/OpenEVSE_PLUS/docs/research/v6.5.1-board-bom.csv

qty | value | package | mount | eagle_device | refs | attributes
1 | JST-VH-6 | JST-VH-6 | THT | OpenEVSE/JST-VH-6 | AC
1 | AMP_CT | MOLEX_2 | THT | OpenEVSE/MOLEX_2 | AMP_CT
2 | 22pf | 0805 | SMD | SparkFun/CAP0805 | C1 C2
13 | .1uf | 0805 | SMD | SparkFun/CAP0805 | C3 C4 C7 C9 C10 C11 C12 C15 C16 C21 C23 C26 C27
4 | 10uf | 0805 | SMD | SparkFun/CAP0805 | C5 C6 C13 C28
2 | 1uf | 0805 | SMD | SparkFun/CAP0805 | C8 C20
2 | 10uf | EIA3216 | SMD | SparkFun/CAP_POL1206 | C14 C22
1 | 10uF | 0603-POLAR | SMD | SparkFun-Capacitors/10UF-POLAR-0603-6.3V-20%(TANT) | C17 | PROD_ID=CAP-13210; VALUE=10uF
1 | 1uF | 0805 | SMD | SparkFun/CAP0805 | C18
1 | 0.1uF | 0805 | SMD | SparkFun/CAP0805 | C19
2 | 22 | 0805 | SMD | SparkFun-Capacitors/1.0UF-0805-25V-(+80/-20%) | C29 C33 | PROD_ID=CAP-11625; VALUE=1.0uF
1 | 100nf | 0805 | SMD | SparkFun-Capacitors/1.0UF-0805-25V-(+80/-20%) | C32 | PROD_ID=CAP-11625; VALUE=1.0uF
1 | AZ23C5V6-7-F | SOT23 | SMD | diode/BAS40-06 | D1
6 | 1N4148 | SOD123 | SMD | diode/DIODE-SOD123 | D2 D3 D4 D5 D6 D12
4 | 1N4004 | SMA | SMD | diode/MBRA340T3 | D7 D8 D9 D10
1 | AZ23C2V7-7-F | SOT23 | SMD | diode/BAS40-06 | D11
1 | DC_RELAY | MOLEX_3 | THT | OpenEVSE/MOLEX_3 | DC_RELAY
1 | BEL1.6AFUSE | BELFUSE1A | THT | Qxd/BEL1AFUSE | F1
4 | FIDUCIAL | FIDUCIAL-1X2.5 | SMD | SparkFun-Retired/FIDUCIAL1X2.5 | FID1 FID2 FID3 FID4
1 | JST6 | JST6 | THT | OpenEVSE/JST6 | FTDI
2 | M01 | 1X01 | THT | SparkFun/M01PTH | G1 G2
1 | GFCI_CT | GFCI_4 | THT | OpenEVSE/GFCI_4 | GFCI_CT
1 | LMV358 | SO08 | SMD | SparkFun-IC-Amplifiers/LMV358SOIC | IC1 | PROD_ID=IC-09657; VALUE=LMV358
1 | ATMEGA328P-AU | TQFP32-08 | SMD | atmel/MEGA8-AI | IC2 | MPN=ATMEGA8-16AU; OC_FARNELL=9171371; OC_NEWARK=73M8863
1 | M04 | JST-4-PTH-VERT | THT | SparkFun-Connectors/M04JST-PTH-VERT | I2C
1 | LM358 | SO08 | SMD | SparkFun/LMV358 | IC3
1 | TC1044S | SO-8 | SMD | OpenEVSE/TC1044S | IC4
1 | AQH2223 | SIL8 | SMD | OpenEVSE/AQH2223 | IC7
1 | HCPL-2731S | SIL8-2 | SMD | OpenEVSE/HCPL-2731S | IC8
1 | ISP1 | AVRISP | THT | adafruit/AVRISP-6 | ISP1
1 | M06 | MOLEX-1X6_LOCK | THT | SparkFun-Connectors/M06POLAR_LOCK | JP2
1 | 3.3uh | MICROBUILDER_INDUCTOR_5X5MM_NR5040_NOTHERMALS | SMD | ESP32_v1_SMPS/MICROBUILDER_INDUCTORNR5040 | L2
1 | BLM21PG331SN1D | INDC2012X87 | SMD | BLM21PG331SN1D/BLM21PG331SN1D | L3 | DESCRIPTION= Ferrite Beads Multi-Layer 330Ohm 25% 100MHz 1.5A 70mOhm DCR 0805 Paper T/R ; MF=Murata; MP=BLM21PG331SN1D; PACKAGE=0805 Murata
4 | MOV | MOV | THT | OpenEVSE/MOV | M1 M2 M3 M4
1 | M02 | SCREWTERMINAL-5MM-2 | THT | SparkFun-Connectors/M025MM | PILOT | STOREFRONT_ID=PRT-08432
1 | IRM-10-5 | IRM-10-5 | THT | OpenEVSE/IRM-10-5 | PS1
1 | 16000 | NX3225 | SMD | adafruit/XTAL-4-3225 | Q1
2 | 2222A | SOT23 | SMD | transistor-npn/BCX70*SMD | Q2 Q3
1 | 820 | 0805 | SMD | SparkFun/RESISTOR0805-RES | R1
6 | 10k | 0805 | SMD | SparkFun/RESISTOR0805-RES | R2 R4 R10 R19 R22 R31
3 | 1k | 0805 | SMD | SparkFun/RESISTOR0805-RES | R3 R12 R20
1 | 56k | 0805 | SMD | SparkFun/RESISTOR0805-RES | R5
7 | 100k | 0805 | SMD | SparkFun/RESISTOR0805-RES | R6 R8 R9 R14 R16 R21 R25
1 | 200k | 0805 | SMD | SparkFun/RESISTOR0805-RES | R7
4 | 330 | 0805 | SMD | SparkFun/RESISTOR0805-RES | R11 R23 R24 R29
1 | 20k | 0805 | SMD | SparkFun/RESISTOR0805-RES | R15
1 | 422 | 0805 | SMD | SparkFun/RESISTOR0805-RES | R17
1 | 100 | 0805 | SMD | SparkFun/RESISTOR0805-RES | R18
1 | 22 | R1206 | SMD | rcl/R-US_R1206 | R26
1 | 2.0 | 0805 | SMD | SparkFun/RESISTOR0805-RES | R27
8 | 180k | 1210 | SMD | SparkFun-Resistors/0.1OHM-1/2W-1%(1210) | R32 R33 R34 R35 R36 R37 R38 R39 | PROD_ID=RES-12374
2 | SHORT-H | SHORT_TOP-50 | SMD | shorts-old/SHORT-HT5 | SH1 SH2 | BOM=no
1 | P6SMB16CA | SMB | SMD | diode/DIODE-SMB | TVS
1 | AP63203 | SOT23-6 | SMD | SparkFun-IC-Power/AP63203 | U1 | PROD_ID=VREG-15244; VALUE=AP63203
2 | HOLE | HOLE | THT | OpenEVSE/HOLE | U$3 U$9
