rylincoln/OpenEVSE_PLUS/OpenEVSE_PLUS_v6.5.1_KiCad/OpenEVSE_PLUS_v6.5.1.kicad_pcb

## KiCad design OpenEVSE_PLUS_v6.5.1_KiCad/OpenEVSE_PLUS_v6.5.1.kicad_pcb (2026-10-25)

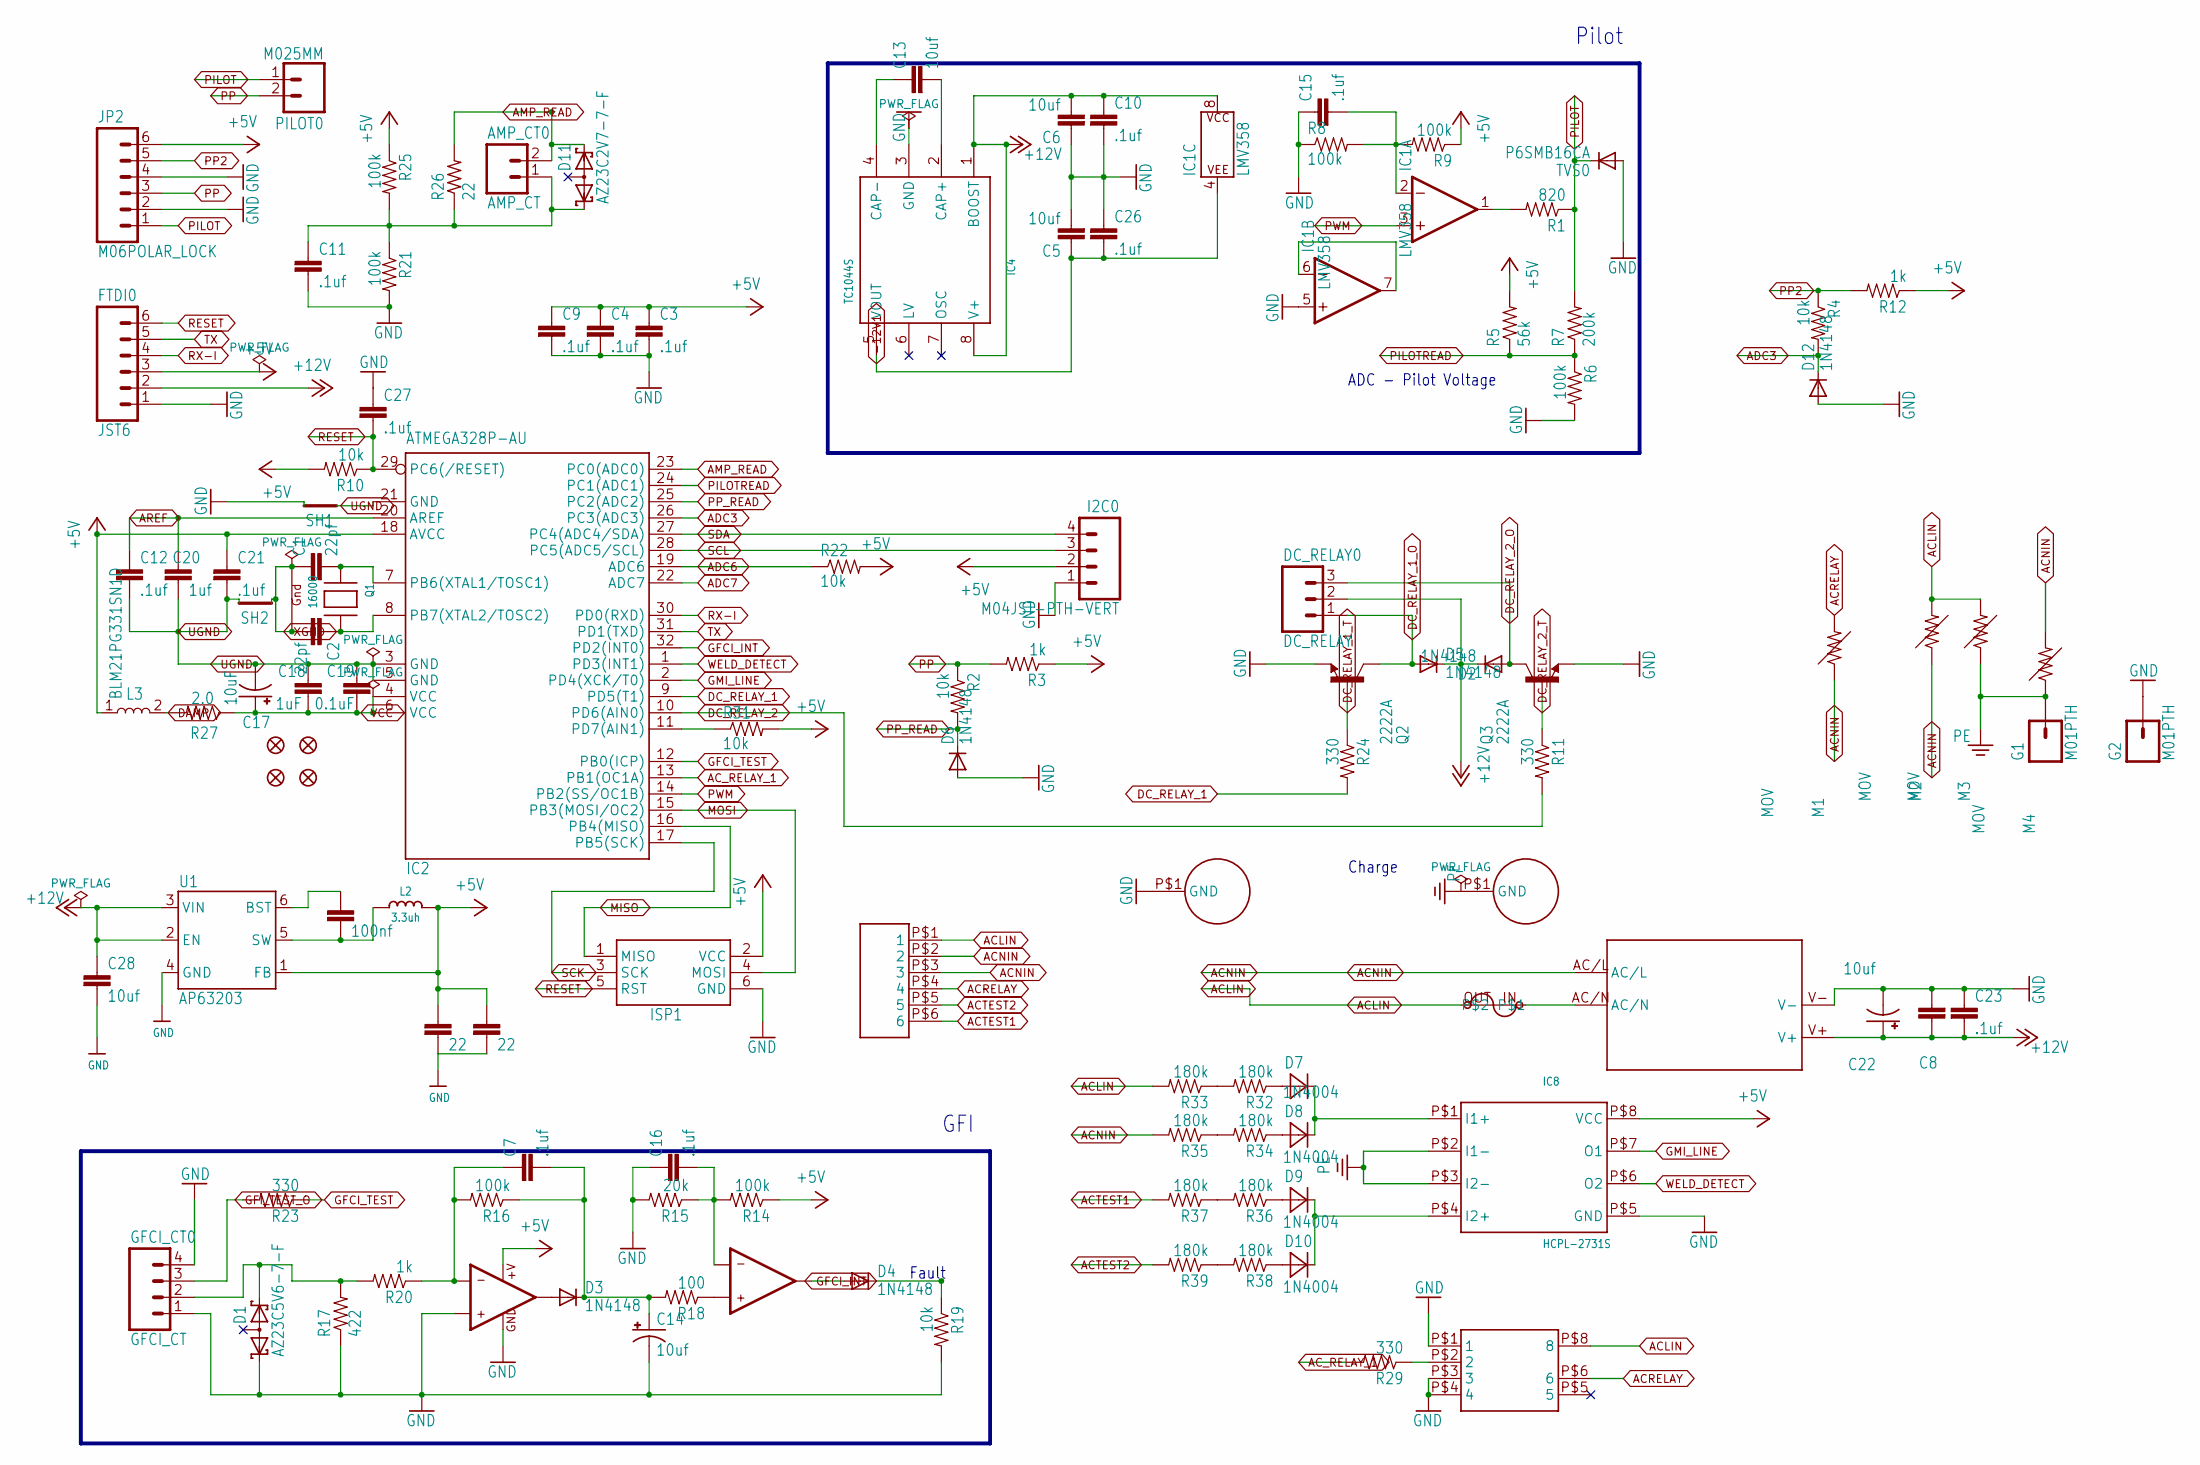
[picture p1: schematic OpenEVSE_PLUS_v6.5.1.kicad_sch]

Parts:
AC0: JST-VH-6
AMP_CT0: AMP_CT; MOLEX_2
C1, C2: 22pf; 0805
C3, C4, C7, C9, C10, C11, C12, C15, C16, C21, C23, C26, C27: .1uf; 0805
C5, C6, C13: 10uf; 0805
C8, C20: 1uf; 0805
C14, C22: 10uf; EIA3216
C17: 10uF; 0603-POLAR
C18: 1uF; 0805
C19: 0.1uF; 0805
C28: 10uf; 0805_SparkFun-Capacitors
C29, C33: 22; 0805_SparkFun-Capacitors
C32: 100nf; 0805_SparkFun-Capacitors
D1: AZ23C5V6-7-F; SOT23
D2, D3, D4, D5, D6, D12: 1N4148; SOD123
D7, D8, D9, D10: 1N4004; SMA
D11: AZ23C2V7-7-F; SOT23
DC_RELAY0: DC_RELAY; MOLEX_3
F1: BEL1.6AFUSE; BELFUSE1A
FID1, FID2, FID3, FID4: FIDUCIAL1X2.5; FIDUCIAL-1X2.5
FTDI0: JST6
G1, G2: M01PTH; 1X01
GFCI_CT0: GFCI_CT; GFCI_4
I2C0: M04JST-PTH-VERT; JST-4-PTH-VERT
IC1: LMV358; SO08_SparkFun-IC-Amplifiers
IC2: ATMEGA328P-AU; TQFP32-08; MPN ATMEGA8-16AU
IC3: LM358; SO08
IC4: TC1044S; SO-8
IC7: AQH2223; SIL8
IC8: HCPL-2731S; SIL8-2
ISP1: ISP1; AVRISP
JP2: M06POLAR_LOCK; MOLEX-1X6_LOCK
L2: 3.3uh; MICROBUILDER_INDUCTOR_5X5MM_NR5040_NOTHERMALS
L3: BLM21PG331SN1D; INDC2012X87
M1, M2, M3, M4: MOV
PILOT0: M025MM; SCREWTERMINAL-5MM-2
PS1: IRM-10-5
Q1: 16000; NX3225
Q2, Q3: 2222A; SOT23_transistor-npn
R1: 820; 0805
R2, R4, R10, R19, R22, R31: 10k; 0805
R3, R12, R20: 1k; 0805
R5: 56k; 0805
R6, R8, R9, R14, R16, R21, R25: 100k; 0805
R7: 200k; 0805
R11, R23, R24, R29: 330; 0805
R15: 20k; 0805
R17: 422; 0805
R18: 100; 0805
R26: 22; R1206
R27: 2.0; 0805
R32, R33, R34, R35, R36, R37, R38, R39: 180k; 1210
SH1, SH2: SHORT-HT5; SHORT_TOP-50
TVS0: P6SMB16CA; SMB
U1: AP63203; SOT23-6
U$3, U$9: HOLE

Connections:
+5V: C3.1, C4.1, C9.1, C21.1, C29.1, C33.1, FTDI0.3, I2C0.2, IC2.18 (AVCC), IC3.8 (+V), IC8.P$8 (VCC), ISP1.2 (VCC), JP2.6, L2.P$2 (2), L3.1, R3.1, R5.2, R9.1, R10.2, R12.1, R14.1, R22.2, R25.1, R31.2, U1.1 (FB)
+12V: C6.2, C8.1, C10.1, C22.A (+), C23.2, C28.1, D2.C, D5.C, DC_RELAY0.2, FTDI0.2, IC1.8 (P$V+), IC4.1 (BOOST), IC4.8 (V+), PS1.V+, U1.2 (EN), U1.3 (VIN)
-12V1: C5.1, C26.2, IC1.4 (P$V-), IC4.5 (VOUT)
ACLIN: AC0.P$1 (1), F1.OUT, IC7.P$8 (8), M2.P$2 (2), M3.P$2 (2), R33.2
ACNIN: AC0.P$2 (2), AC0.P$3 (3), M1.P$1 (1), M2.P$1 (1), M4.P$2 (2), PS1.AC/L, R35.2
ACRELAY: AC0.P$4 (4), IC7.P$6 (6), M1.P$2 (2)
ACTEST1: AC0.P$6 (6), R37.2
ACTEST2: AC0.P$5 (5), R39.2
AC_RELAY_1: IC2.13 (PB1(OC1A)), R29.2
ADC3: D12.C, IC2.26 (PC3(ADC3)), R4.2
ADC6: IC2.19 (ADC6), R22.1
ADC7: IC2.22 (ADC7)
AMP_READ: AMP_CT0.2, D11.2 (K2), IC2.23 (PC0(ADC0)), R26.2
AREF: C12.1, C20.1, IC2.20 (AREF)
DAMP: L3.2, R27.2
DC_RELAY_1: IC2.9 (PD5(T1)), R24.2
DC_RELAY_1_O: D5.A, DC_RELAY0.1, Q2.3 (C)
DC_RELAY_1_T: Q2.1 (B), R24.1
DC_RELAY_2: IC2.10 (PD6(AIN0)), R11.2
DC_RELAY_2_O: D2.A, DC_RELAY0.3, Q3.3 (C)
DC_RELAY_2_T: Q3.1 (B), R11.1
GFCI_INT: D4.C, IC2.32 (PD2(INT0)), R19.1
GFCI_TEST: IC2.12 (PB0(ICP)), R23.1
GFI_TEST_O: GFCI_CT0.3, R23.2
GMI_LINE: IC2.2 (PD4(XCK/T0)), IC8.P$7 (O1)
GND: C3.2, C4.2, C5.2, C6.1, C8.2, C9.2, C10.2, C11.2, C14.C (-), C15.1, C16.1, C22.C (-), C23.1, C26.1, C27.1, C28.2, C29.2, C33.2, D1.1 (K1), D6.A, D12.A, FTDI0.1, G2.1 (1_1), GFCI_CT0.1, GFCI_CT0.4, I2C0.1, IC1.5 (+IN), IC3.3 (+IN1), IC3.4 (GND), IC4.3 (GND), IC7.P$1 (1), IC7.P$3 (3), IC7.P$4 (4), IC8.P$5 (GND), ISP1.6 (GND), JP2.2, JP2.4, PS1.V-, Q2.2 (E), Q3.2 (E), R6.2, R8.1, R15.2, R17.1, R19.2, R21.2, SH1.2, TVS0.A, U1.4 (GND), U$9.P$1 (GND_P$1)
MISO: IC2.16 (PB4(MISO)), ISP1.1 (MISO)
MOSI: IC2.15 (PB3(MOSI/OC2)), ISP1.4 (MOSI)
unnamed: C7.2, C14.A (+), D3.C, R16.1, R18.2
unnamed: D1.2 (K2), GFCI_CT0.2, R17.2, R20.2
unnamed: D7.A, R32.1
unnamed: D8.A, R34.1
unnamed: D9.A, R36.1
unnamed: D10.A, R38.1
unnamed: AMP_CT0.1, C11.1, D11.1 (K1), R21.1, R25.2, R26.1
unnamed: F1.IN, PS1.AC/N
unnamed: C15.2, IC1.2 (-IN), R8.2, R9.2
unnamed: IC1.1 (OUT), R1.2
unnamed: IC1.6 (-IN), IC1.7 (OUT)
unnamed: C1.2, IC2.7 (PB6(XTAL1/TOSC1)), Q1.2 (X1)
unnamed: C2.1, IC2.8 (PB7(XTAL2/TOSC2)), Q1.4 (X2)
unnamed: IC2.11 (PD7(AIN1)), R31.1
unnamed: C7.1, IC3.2 (-IN1), R16.2, R20.1
unnamed: D3.A, IC3.1 (OUT1)
unnamed: IC3.5 (+IN2), R18.1
unnamed: C16.2, IC3.6 (-IN2), R14.2, R15.1
unnamed: D4.A, IC3.7 (OUT2)
unnamed: C13.2, IC4.2 (CAP+)
unnamed: C13.1, IC4.4 (CAP-)
unnamed: IC7.P$2 (2), R29.1
unnamed: D7.C, D8.C, IC8.P$1 (I1+)
unnamed: D9.C, D10.C, IC8.P$4 (I2+)
unnamed: C32.2, L2.P$1 (1), U1.5 (SW)
unnamed: R32.2, R33.1
unnamed: R34.2, R35.1
unnamed: R36.2, R37.1
unnamed: R38.2, R39.1
unnamed: C32.1, U1.6 (BST)
PE: G1.1 (1_1), IC8.P$2 (I1-), IC8.P$3 (I2-), M3.P$1 (1), M4.P$1 (1), U$3.P$1 (GND_P$1)
PILOT: JP2.1, PILOT0.1, R1.1, R7.2, TVS0.C
PILOTREAD: IC2.24 (PC1(ADC1)), R5.1, R6.1, R7.1
PP: JP2.3, PILOT0.2, R2.1, R3.2
PP2: JP2.5, R4.1, R12.2
PP_READ: D6.C, IC2.25 (PC2(ADC2)), R2.2
PWM: IC1.3 (+IN), IC2.14 (PB2(SS/OC1B))
RESET: C27.2, FTDI0.6, IC2.29 (PC6(/RESET)), ISP1.5 (RST), R10.1
RX-I: FTDI0.4, IC2.30 (PD0(RXD))
SCK: IC2.17 (PB5(SCK)), ISP1.3 (SCK)
SCL: I2C0.3, IC2.28 (PC5(ADC5/SCL))
SDA: I2C0.4, IC2.27 (PC4(ADC4/SDA))
TX: FTDI0.5, IC2.31 (PD1(TXD))
UGND: C12.2, C17.-, C18.1, C19.1, C20.2, C21.2, IC2.3 (GND), IC2.5 (GND), IC2.21 (GND), SH1.1, SH2.2
VCC: C17.+, C18.2, C19.2, IC2.4 (VCC), IC2.6 (VCC), R27.1
WELD_DETECT: IC2.1 (PD3(INT1)), IC8.P$6 (O2)
XGND: C1.1, C2.2, Q1.1 (G1), Q1.3 (G2), SH2.1

Notes on the sheet:
ADC - Pilot Voltage
Pilot
Fault
GFI
Charge

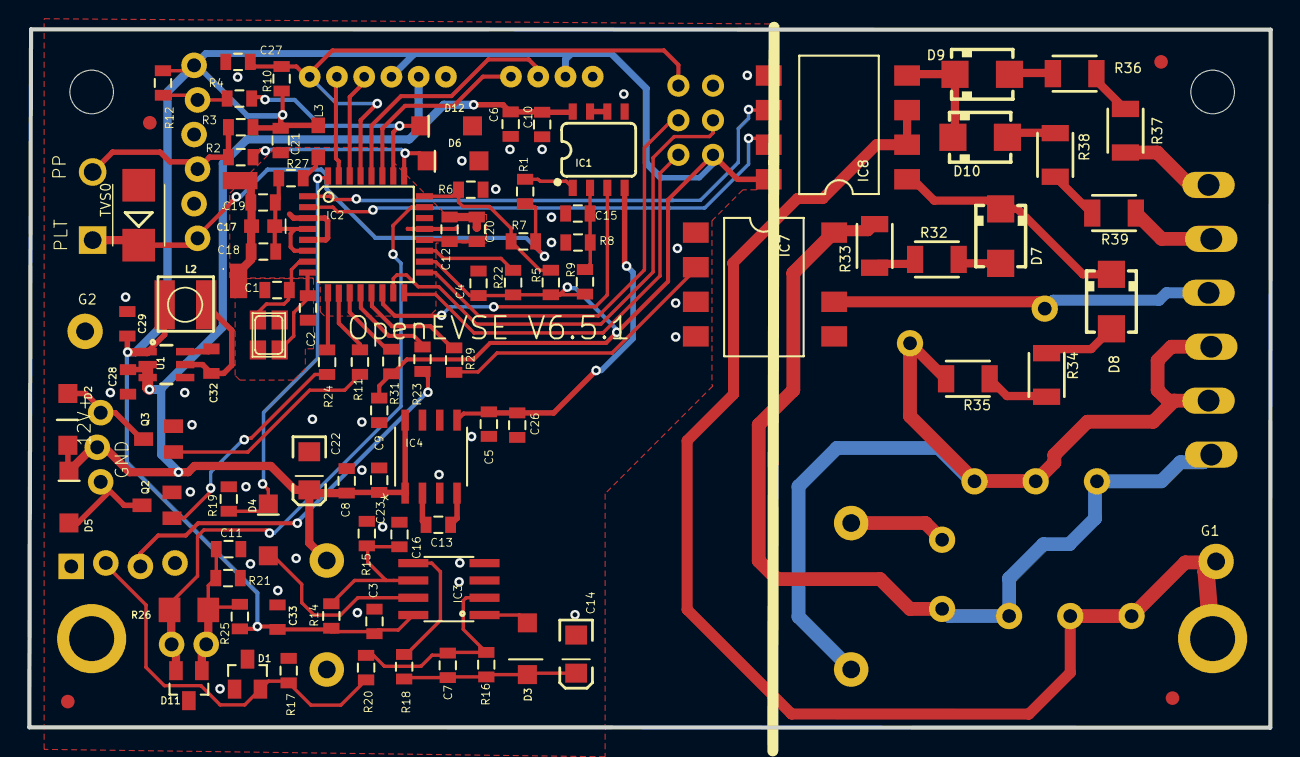
[picture p2: board OpenEVSE_PLUS_v6.5.1.kicad_pcb from above]

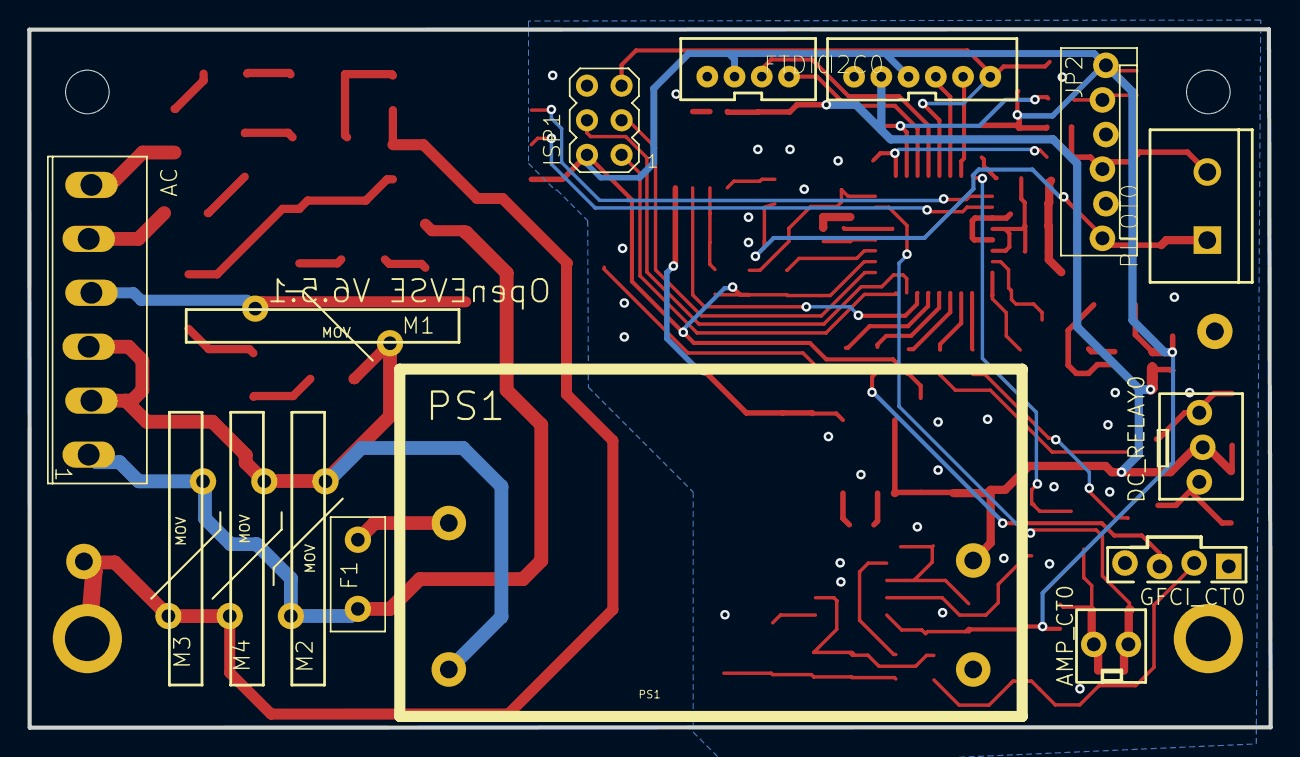
[picture p3: board OpenEVSE_PLUS_v6.5.1.kicad_pcb from below]

Board: 2 copper layers, 91.1 x 51.3 mm, 117 parts (15 on the bottom side), 74 nets.

Other parts of the board:
H1, H2: MountingHole_3.2mm_NPTH
