rylincoln/OpenEVSE_PLUS/(commit log)

2026-10-25 Add v6.5.1 design review, BOM and sourcing research
    - docs/research/v6.5.1-design-review.md: build parts list, verification
    results (connectivity, mains spacing, pilot simulation) and ranked
    enhancements for v6.5.1 2-layer and 6-layer boards
    - docs/research/v6.5.1-sourcing-research.md: station parts, datasheet
    checks and corrected MPNs with sources
    - docs/research/v6.5.1-board-bom.csv: BOM extracted from the EAGLE schematic
    - docs/research/scripts: BOM extractor, netlist comparator, KiCad
    mains-spacing rules and ngspice pilot testbench
    - CLAUDE.md: v6.5.1+ scope, KiCad/ngspice tooling, pointer to research
    [v6.5.1-board-bom.csv]
2026-10-25 Add KiCad 10 port of the v6.5.1 2-layer board
    1:1 port of OpenEVSE_PLUS_v6.5.1/*.sch/.brd (EAGLE 9.6.2) into
    OpenEVSE_PLUS_v6.5.1_KiCad/. No design changes. The raw KiCad import
    was cleaned up by two scripts (docs/research/scripts/port/):
    sch_fix.py (from the ERC report and the EAGLE .sch)
    - 40 wire stubs trimmed to their labels, 3 EAGLE dangling stubs removed
    - junction restored at the dropped U1 FB / +5V T-connection
    - no-connect flags on D1.3, D11.3, IC4 LV, IC4 OSC, IC7.5
    - PWR_FLAGs on +12V, +5V, XGND, UGND, VCC, GND, PE
    - global labels for 8 EAGLE nets that were named without a label
    (XGND, -12V1, DAMP, GFI_TEST_O, DC_RELAY_1_O/T, DC_RELAY_2_O/T)
    - SH1/SH2 excluded from BOM (EAGLE B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
    [OpenEVSE_PLUS_v6.5.1.kicad_pcb, OpenEVSE_PLUS_v6.5.1.kicad_sch]
2026-10-25 Link the KiCad board to its schematic
    Update PCB from Schematic (KiCad 10 GUI): re-link by reference, replace
    footprints, update fields; 0 errors, 4 warnings (FID1-4 copper pad with
    no symbol pin, no net in EAGLE either).
    pcb_geomdiff.py (new) compared the board before and after with nets
    matched by their pads: 686 segments, 63 vias, 6 zones, 21 graphics and
    all 117 footprint placements/pads identical. Only the expected changes:
    30 N$ nets renamed to Net-(...), 21 symbol fields copied, 3 connector
    values filled, 5 open pads given unconnected-* nets, sheet paths added.
    netcmp: 0 differing nets vs EAGLE .brd and vs the schematic netlist.
    DRC unchanged (0 unconnected, 3 pre-existing errors).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
    [OpenEVSE_PLUS_v6.5.1.kicad_pcb]
2026-10-25 Enable the kicad-happy plugin for this project
